KJ7ILJ/uofa-soven1/pi_details.pdf

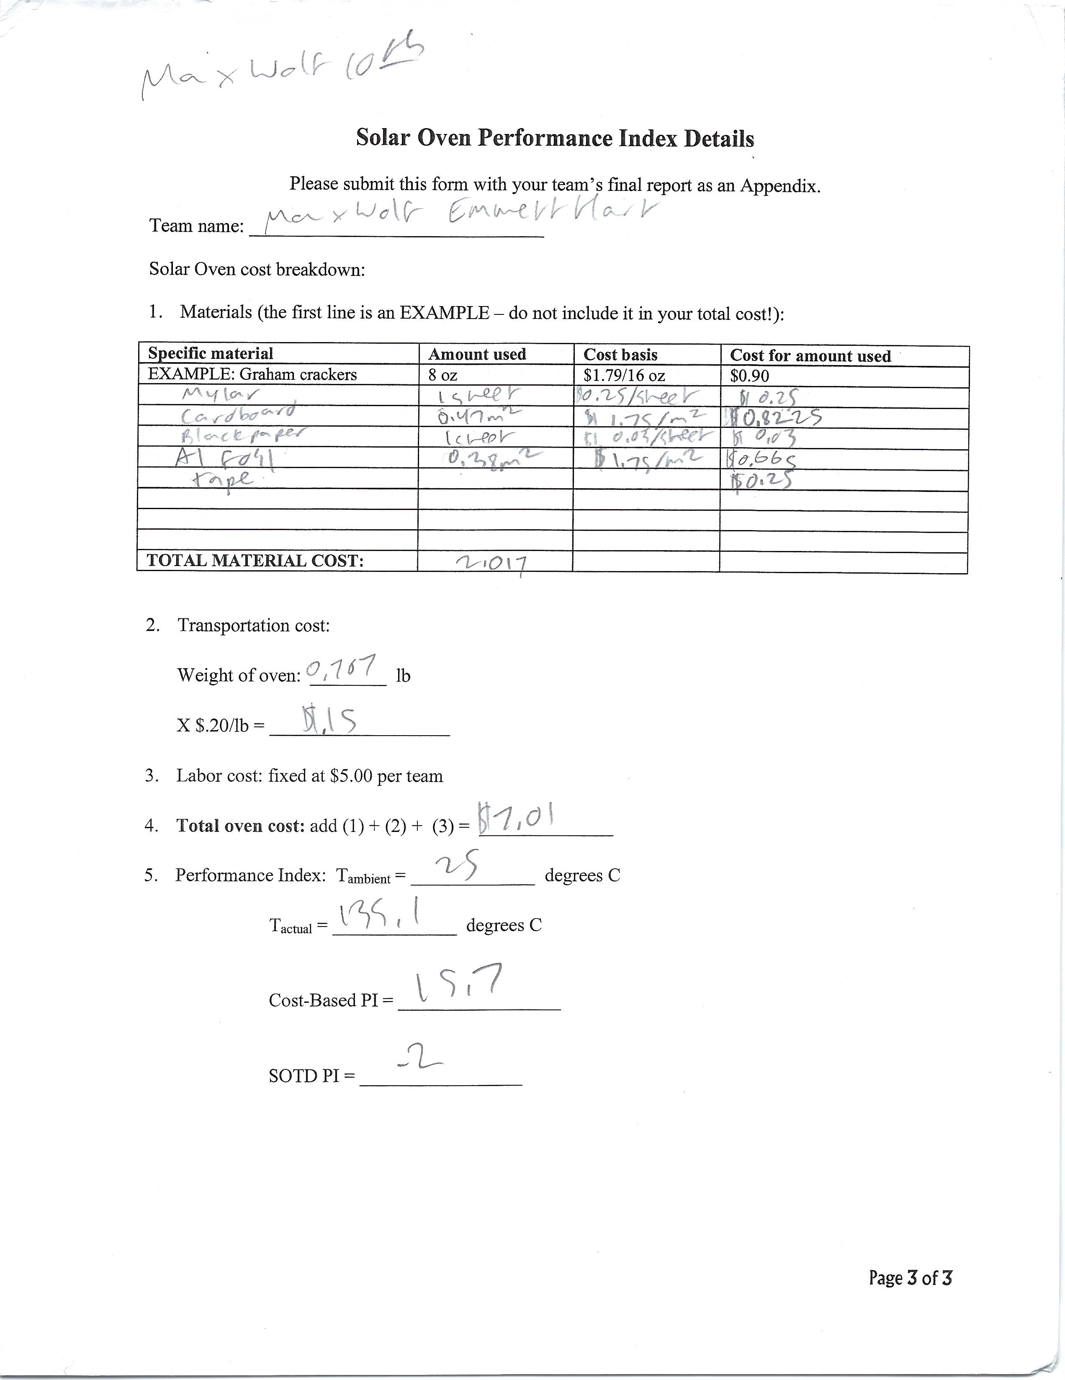
[picture p7: page 1]
