KJ7ILJ/uofa-soven1/oven1_2020-Jan-30_04-13-16AM-000_CustomizedView34793112292.png

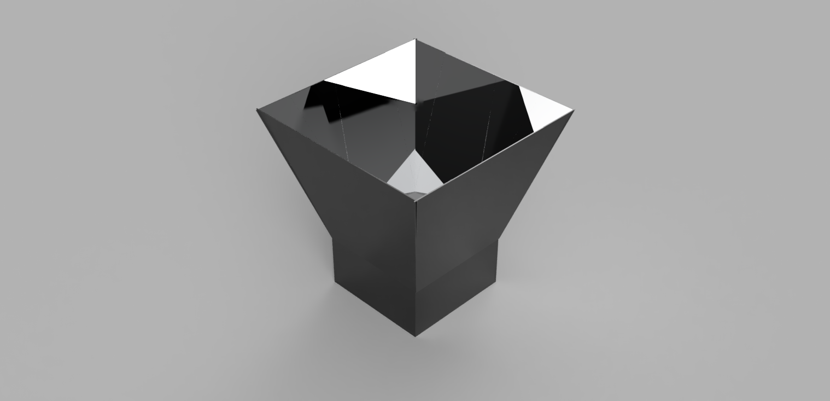
oven1_2020-Jan-30_04-13-16AM-000_CustomizedView34793112292.png
