KJ7ILJ/uofa-soven1/(list of files, cad)

Other CAD files:
oven1 v1.f3d
